gaduffl/pill_dispenser/docs/img/base.png

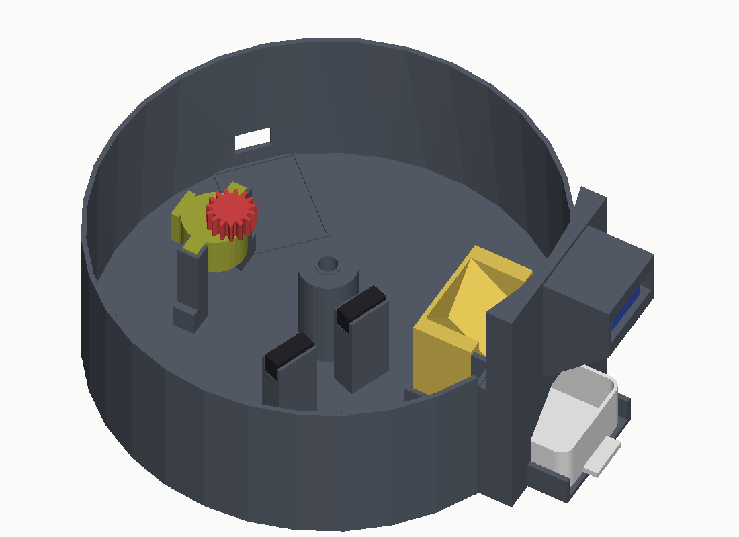
docs/img/base.png
