gaduffl/pill_dispenser/docs/img/section.png

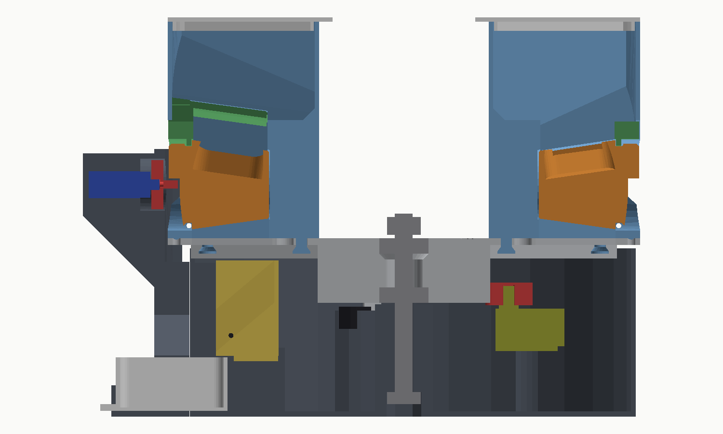
docs/img/section.png
