gaduffl/pill_dispenser/step/assembly.step

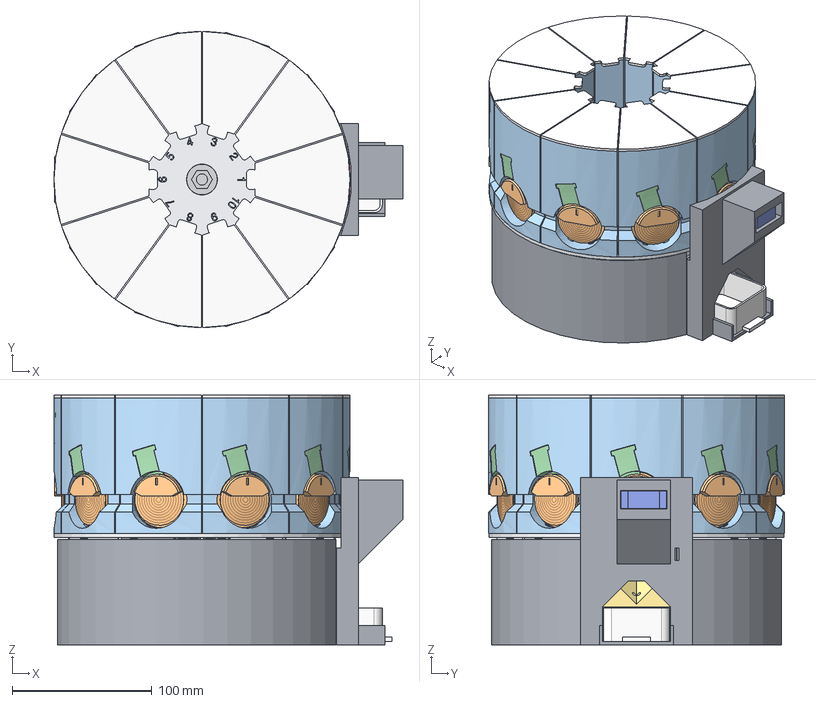
[picture p5: CAD file, 2026-11-13]
step/assembly.step
250.0 x 212.0 x 179.0 mm
base_tub
tower
chute
cup
drive_dog
pinion
carousel
ref_28BYJ48
ref_MG90S
ref_M8_axle_608
ref_light_barrier_home_rx
ref_light_barrier_home_tx
ref_light_barrier_drop_a
ref_light_barrier_drop_b
module_1
roller_1
gate_1
lid_1
module_2
roller_2
gate_2
lid_2
module_3
roller_3
gate_3
lid_3
module_4
roller_4
gate_4
lid_4
module_5
roller_5
gate_5
lid_5
module_6
roller_6
gate_6
lid_6
module_7
roller_7
gate_7
lid_7
module_8
roller_8
gate_8
lid_8
module_9
roller_9
gate_9
lid_9
module_10
roller_10
gate_10
lid_10
