gaduffl/pill_dispenser/step/carousel.step

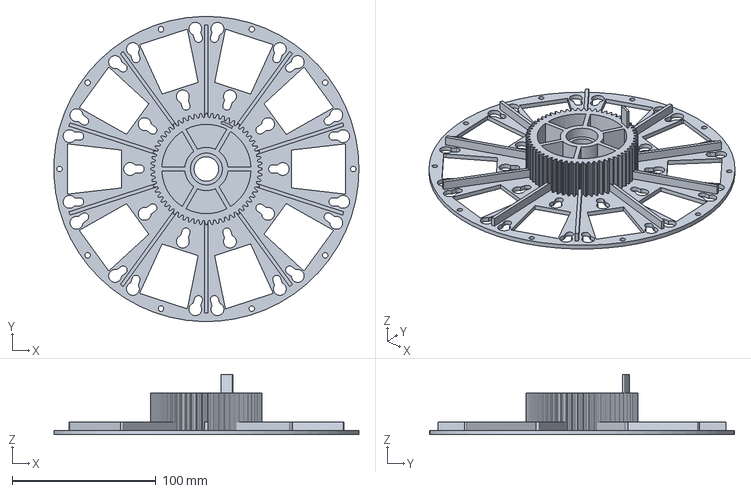
[picture p7: CAD file, 2026-11-13]
step/carousel.step
211.8 x 211.9 x 42.0 mm
