gaduffl/pill_dispenser/step/gate_L_cap0.step

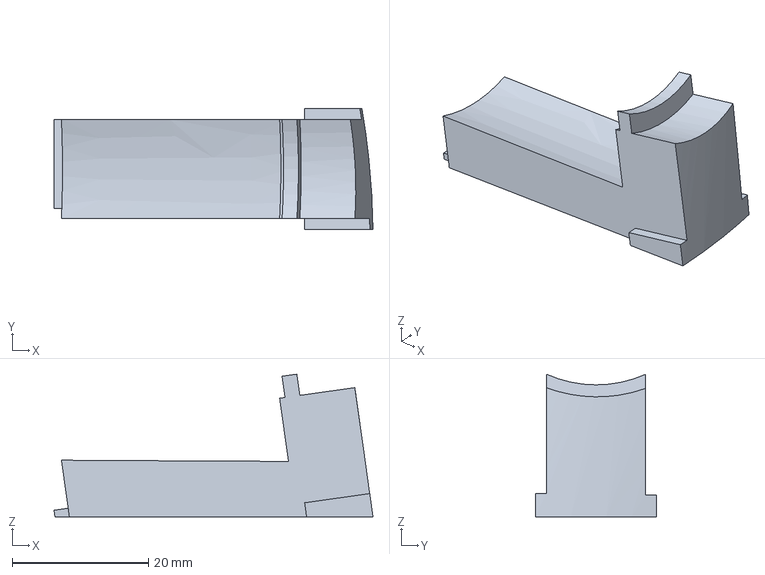
[picture p8: CAD file, 2026-11-13]
step/gate_L_cap0.step
46.8 x 17.8 x 20.9 mm
