gaduffl/pill_dispenser/step/pinion.step

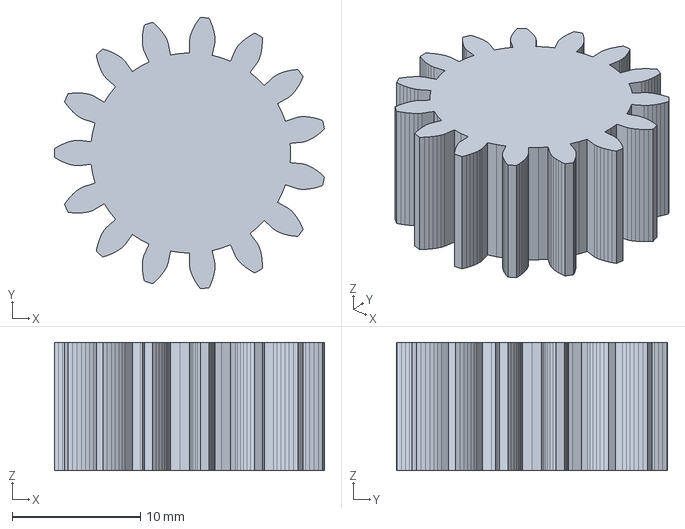
[picture p9: CAD file, 2026-11-13]
step/pinion.step
21.1 x 21.2 x 10.0 mm
