gaduffl/pill_dispenser/step/chute.step

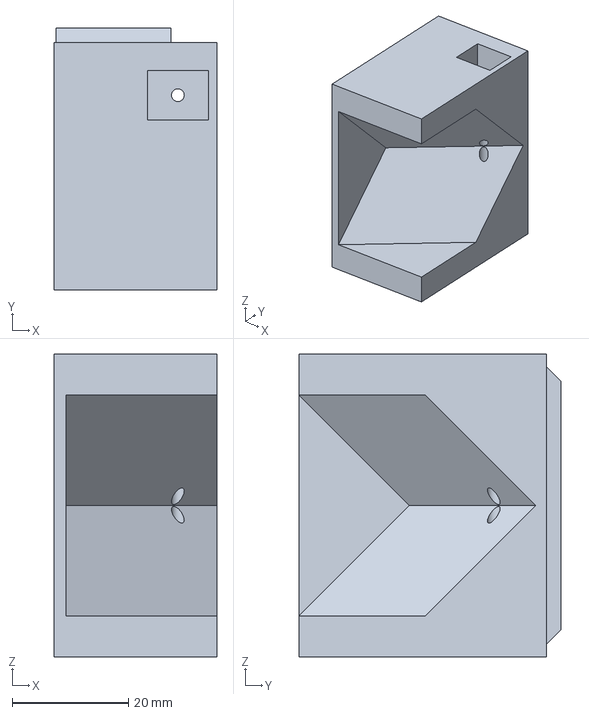
[picture p10: CAD file, 2026-11-13]
step/chute.step
28.0 x 45.2 x 52.2 mm
