gaduffl/pill_dispenser/step/gate_XL_soft.step

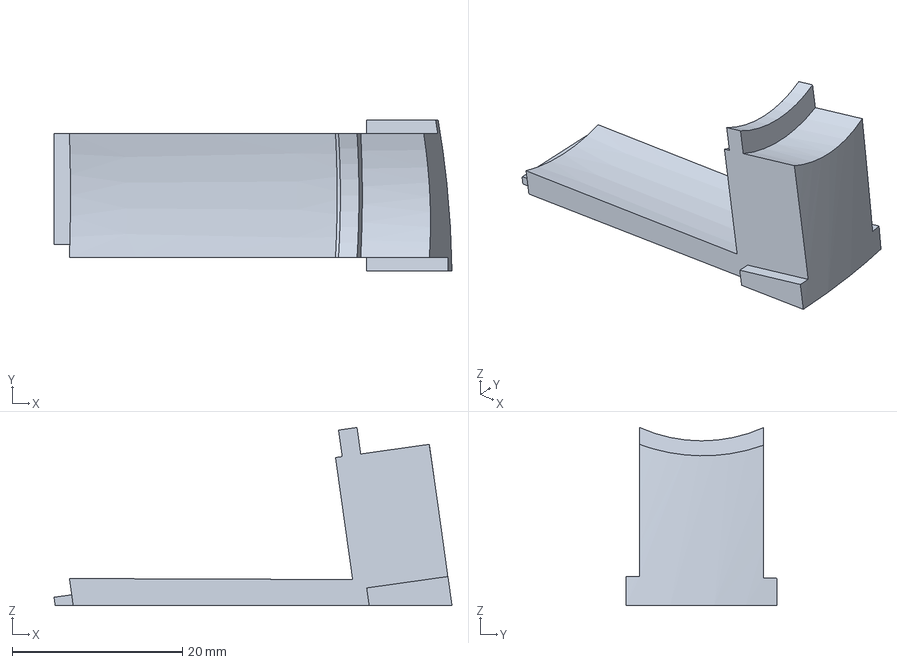
[picture p11: CAD file, 2026-11-13]
step/gate_XL_soft.step
46.8 x 17.8 x 20.9 mm
