gaduffl/pill_dispenser/step/module_body.step

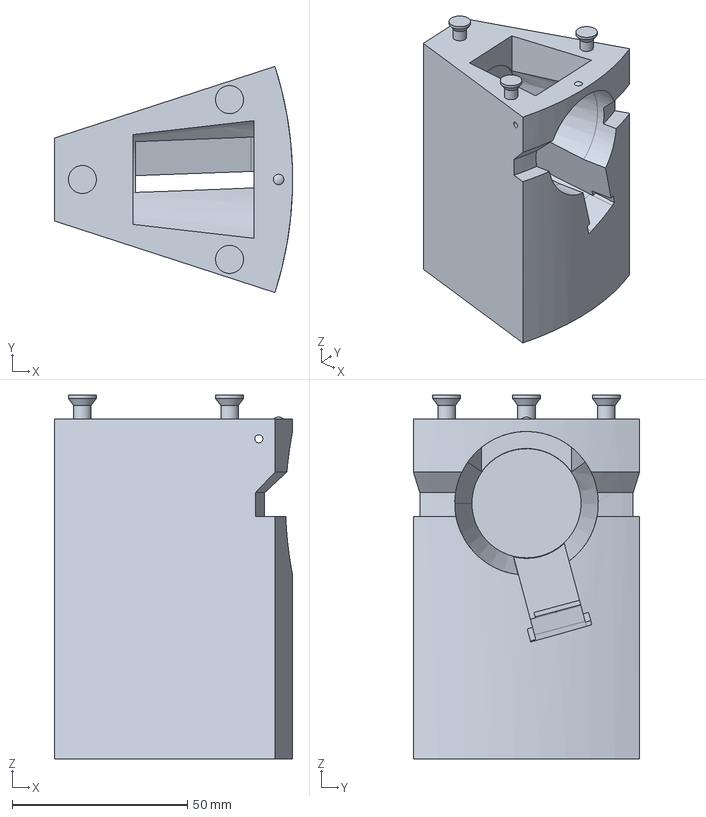
[picture p12: CAD file, 2026-11-13]
step/module_body.step
68.0 x 64.6 x 103.9 mm
