gaduffl/pill_dispenser/step/roller_M_tab10.step

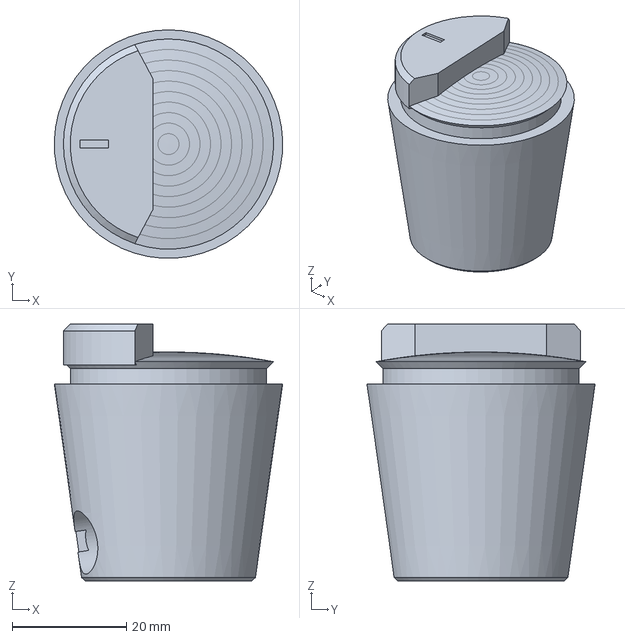
[picture p13: CAD file, 2026-11-13]
step/roller_M_tab10.step
40.0 x 40.0 x 45.0 mm
