gaduffl/pill_dispenser/step/cup.step

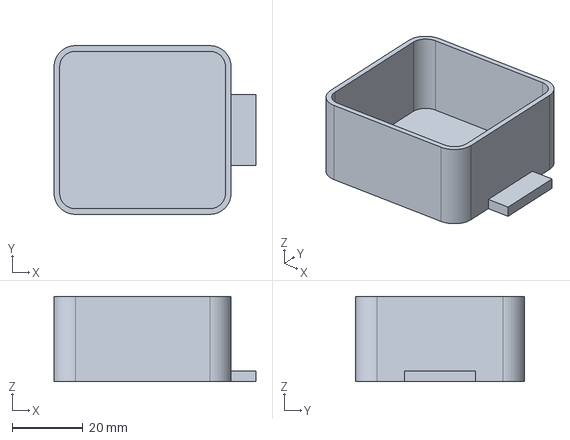
[picture p15: CAD file, 2026-11-13]
step/cup.step
57.0 x 47.6 x 24.0 mm
