gaduffl/pill_dispenser/step/module_lid.step

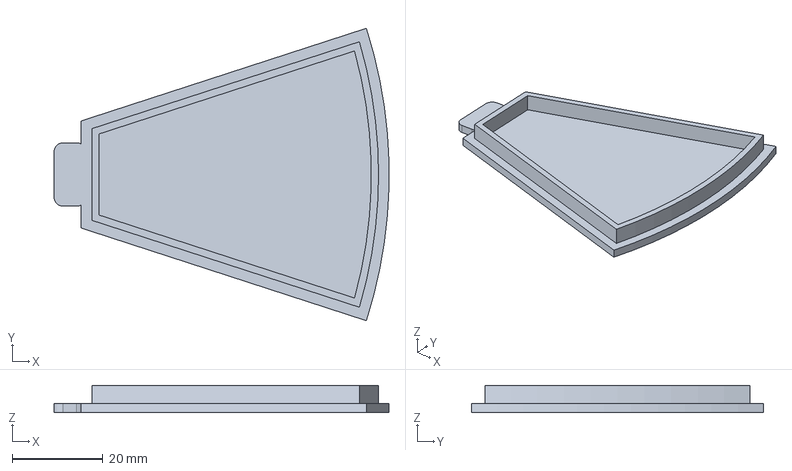
[picture p16: CAD file, 2026-11-13]
step/module_lid.step
74.0 x 64.6 x 6.00 mm
