gaduffl/pill_dispenser/step/hub_cap.step

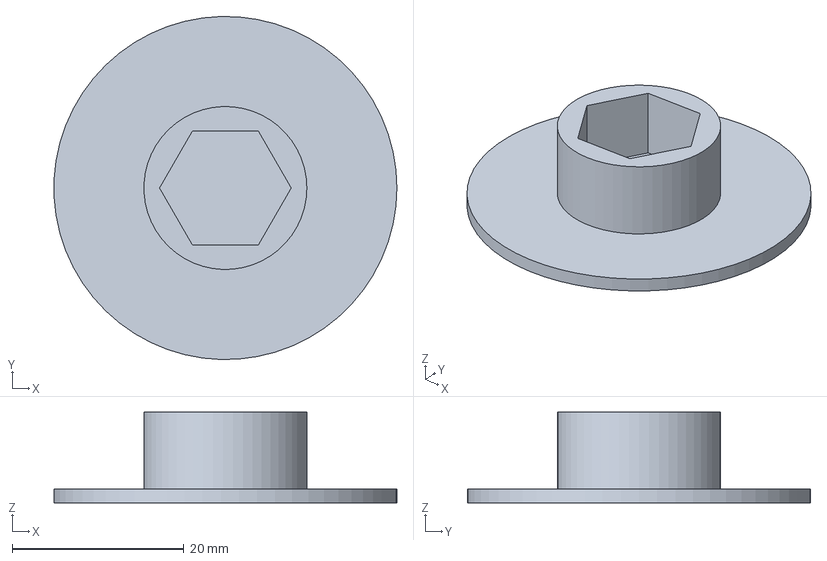
[picture p17: CAD file, 2026-11-13]
step/hub_cap.step
40.0 x 40.0 x 10.6 mm
