gaduffl/pill_dispenser/step/roller_XL_soft.step

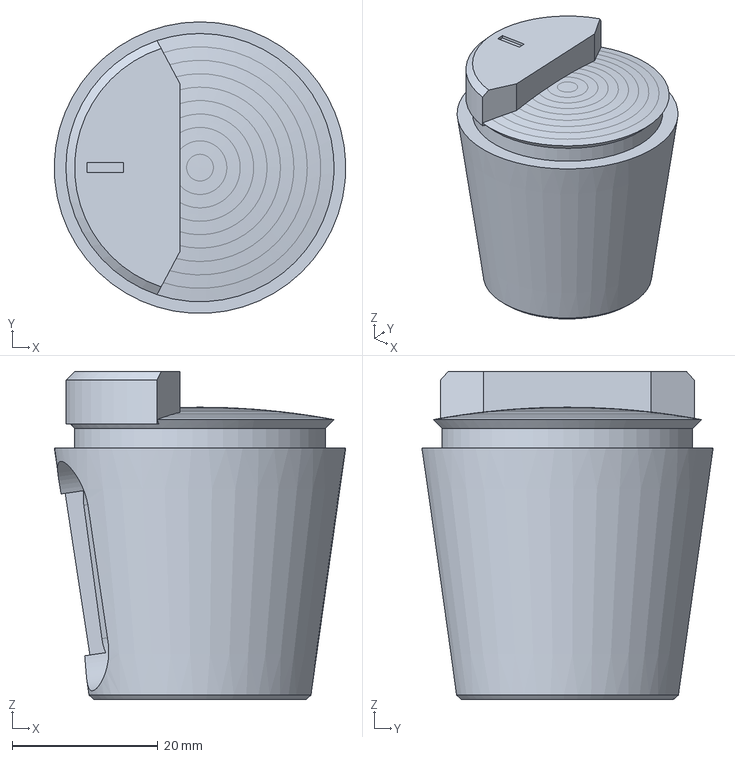
[picture p18: CAD file, 2026-11-13]
step/roller_XL_soft.step
40.0 x 40.0 x 45.0 mm
