gaduffl/pill_dispenser/step/base_tub.step

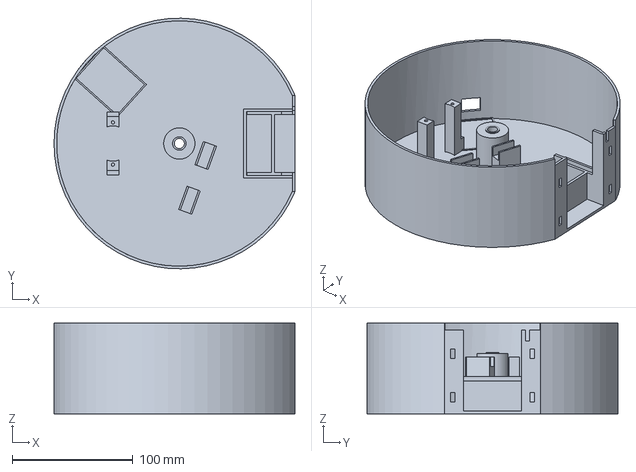
[picture p19: CAD file, 2026-11-13]
step/base_tub.step
200.0 x 208.0 x 75.5 mm
