gaduffl/pill_dispenser/step/gate_M_tab10.step

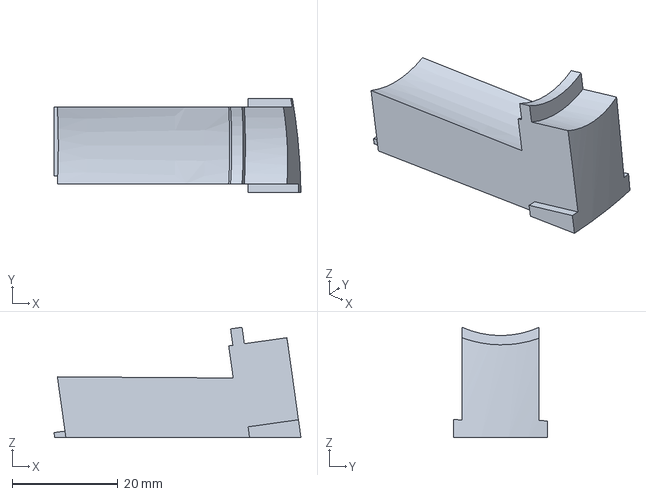
[picture p20: CAD file, 2026-11-13]
step/gate_M_tab10.step
46.8 x 17.8 x 20.9 mm
