gaduffl/pill_dispenser/step/drive_dog.step

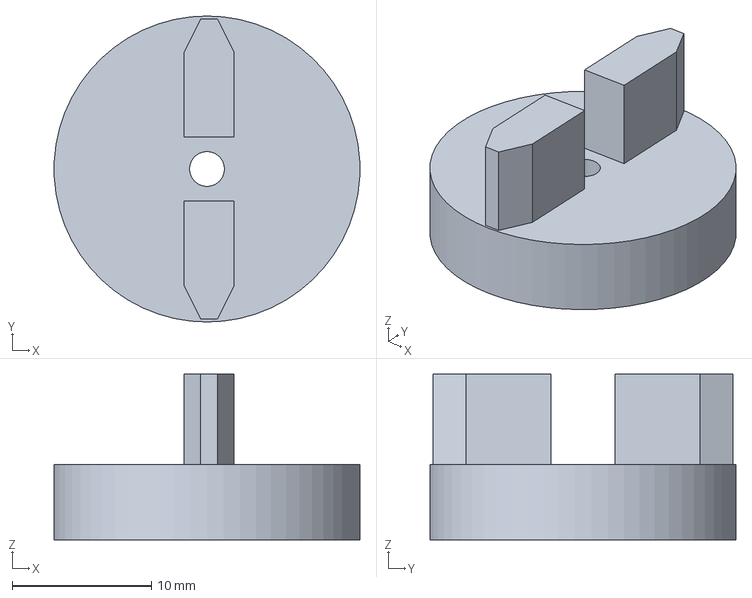
[picture p21: CAD file, 2026-11-13]
step/drive_dog.step
22.0 x 22.0 x 11.9 mm
