gaduffl/pill_dispenser/step/gate_S_tab6.step

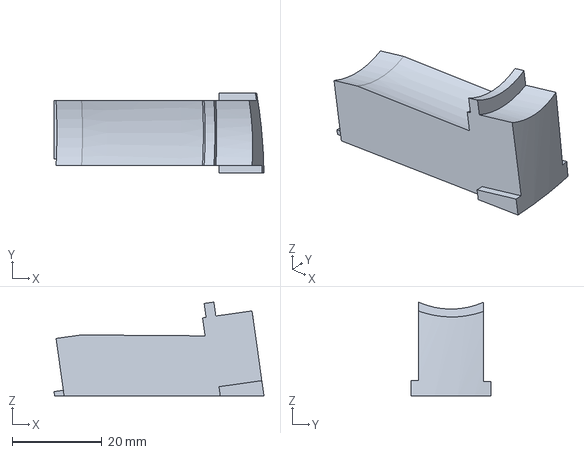
[picture p22: CAD file, 2026-11-13]
step/gate_S_tab6.step
46.8 x 17.8 x 20.9 mm
