gaduffl/pill_dispenser/step/tower.step

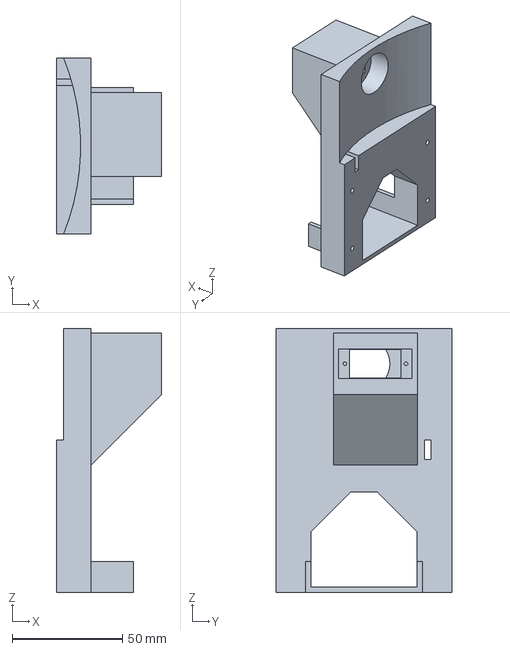
[picture p23: CAD file, 2026-11-13]
step/tower.step
47.8 x 80.0 x 120.0 mm
