gaduffl/pill_dispenser/step/roller_L_cap00.step

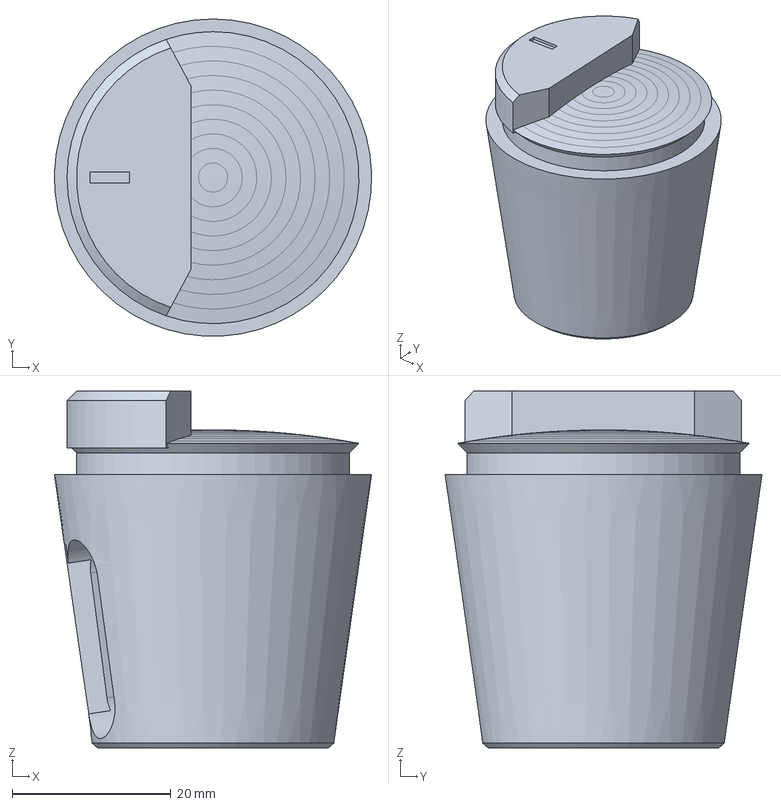
[picture p24: CAD file, 2026-11-13]
step/roller_L_cap00.step
40.0 x 40.0 x 45.0 mm
