gaduffl/pill_dispenser/step/roller_S_tab6.step

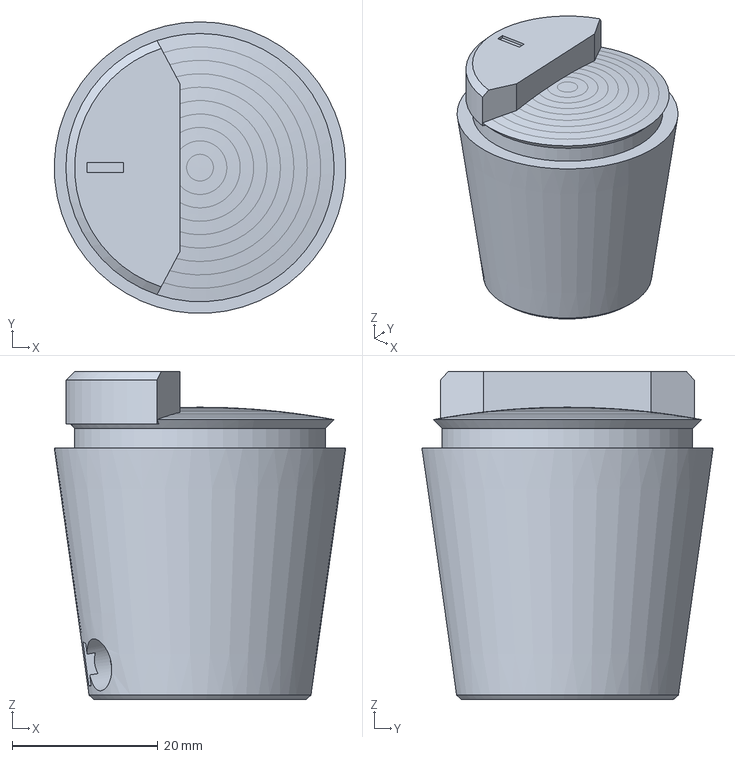
[picture p25: CAD file, 2026-11-13]
step/roller_S_tab6.step
40.0 x 40.0 x 45.0 mm
