gaduffl/pill_dispenser/(list of files, cad)

Other CAD files:
stl/base_tub.stl
stl/carousel.stl
stl/chute.stl
stl/cup.stl
stl/drive_dog.stl
stl/gate_L_cap0.stl
stl/gate_L_cap00.stl
stl/gate_M_tab10.stl
stl/gate_S_tab6.stl
stl/gate_XL_soft.stl
stl/hub_cap.stl
stl/module_body.stl
stl/module_lid.stl
stl/pinion.stl
stl/roller_L_cap0.stl
stl/roller_L_cap00.stl
stl/roller_M_tab10.stl
stl/roller_S_tab6.stl
stl/roller_XL_soft.stl
stl/tower.stl
