gaduffl/pill_dispenser/firmware/pilldispenser/secrets.example.h

// Optional. Copy to secrets.h to bake credentials into the firmware instead of using the setup access point.
#define WIFI_SSID "your-wifi"
#define WIFI_PASS "your-password"
#define API_KEY   "choose-a-long-random-string"
